dgaff/tixclock/(threads)

Thread 1 (2023-07-10):

Question about 24-hour mode

krhainos, 2023-07-10:
I have an original Cube Root TIX Clock and I'm not able to set it to a 24-hour display by holding down "Mode" while it's being powered up.  I've lost the original AC-AC adapter, but the clock appears to work and is keeping time correctly with a 6V 600mA adapter I found.

Is it possible my unit is an early version that doesn't contain the code for switching to 24-hour mode, or could my aftermarket supply be at fault?

Closed 2023-07-28.
