dgaff/tixclock/(commit log)

2026-10-15 Add donation button to README
    Added a 'Buy Me a Coffee' button to the README.
2026-11-11 Revise code review notes for clarity and updates
    Updated notes on platformio.ini and board configuration, clarified pin differences, and fixed deprecated attribute usage.
